Dizzerin/Rocket-Flight-Data-Computer/PCB_Schematics_KiCAD/Schematic.pdf

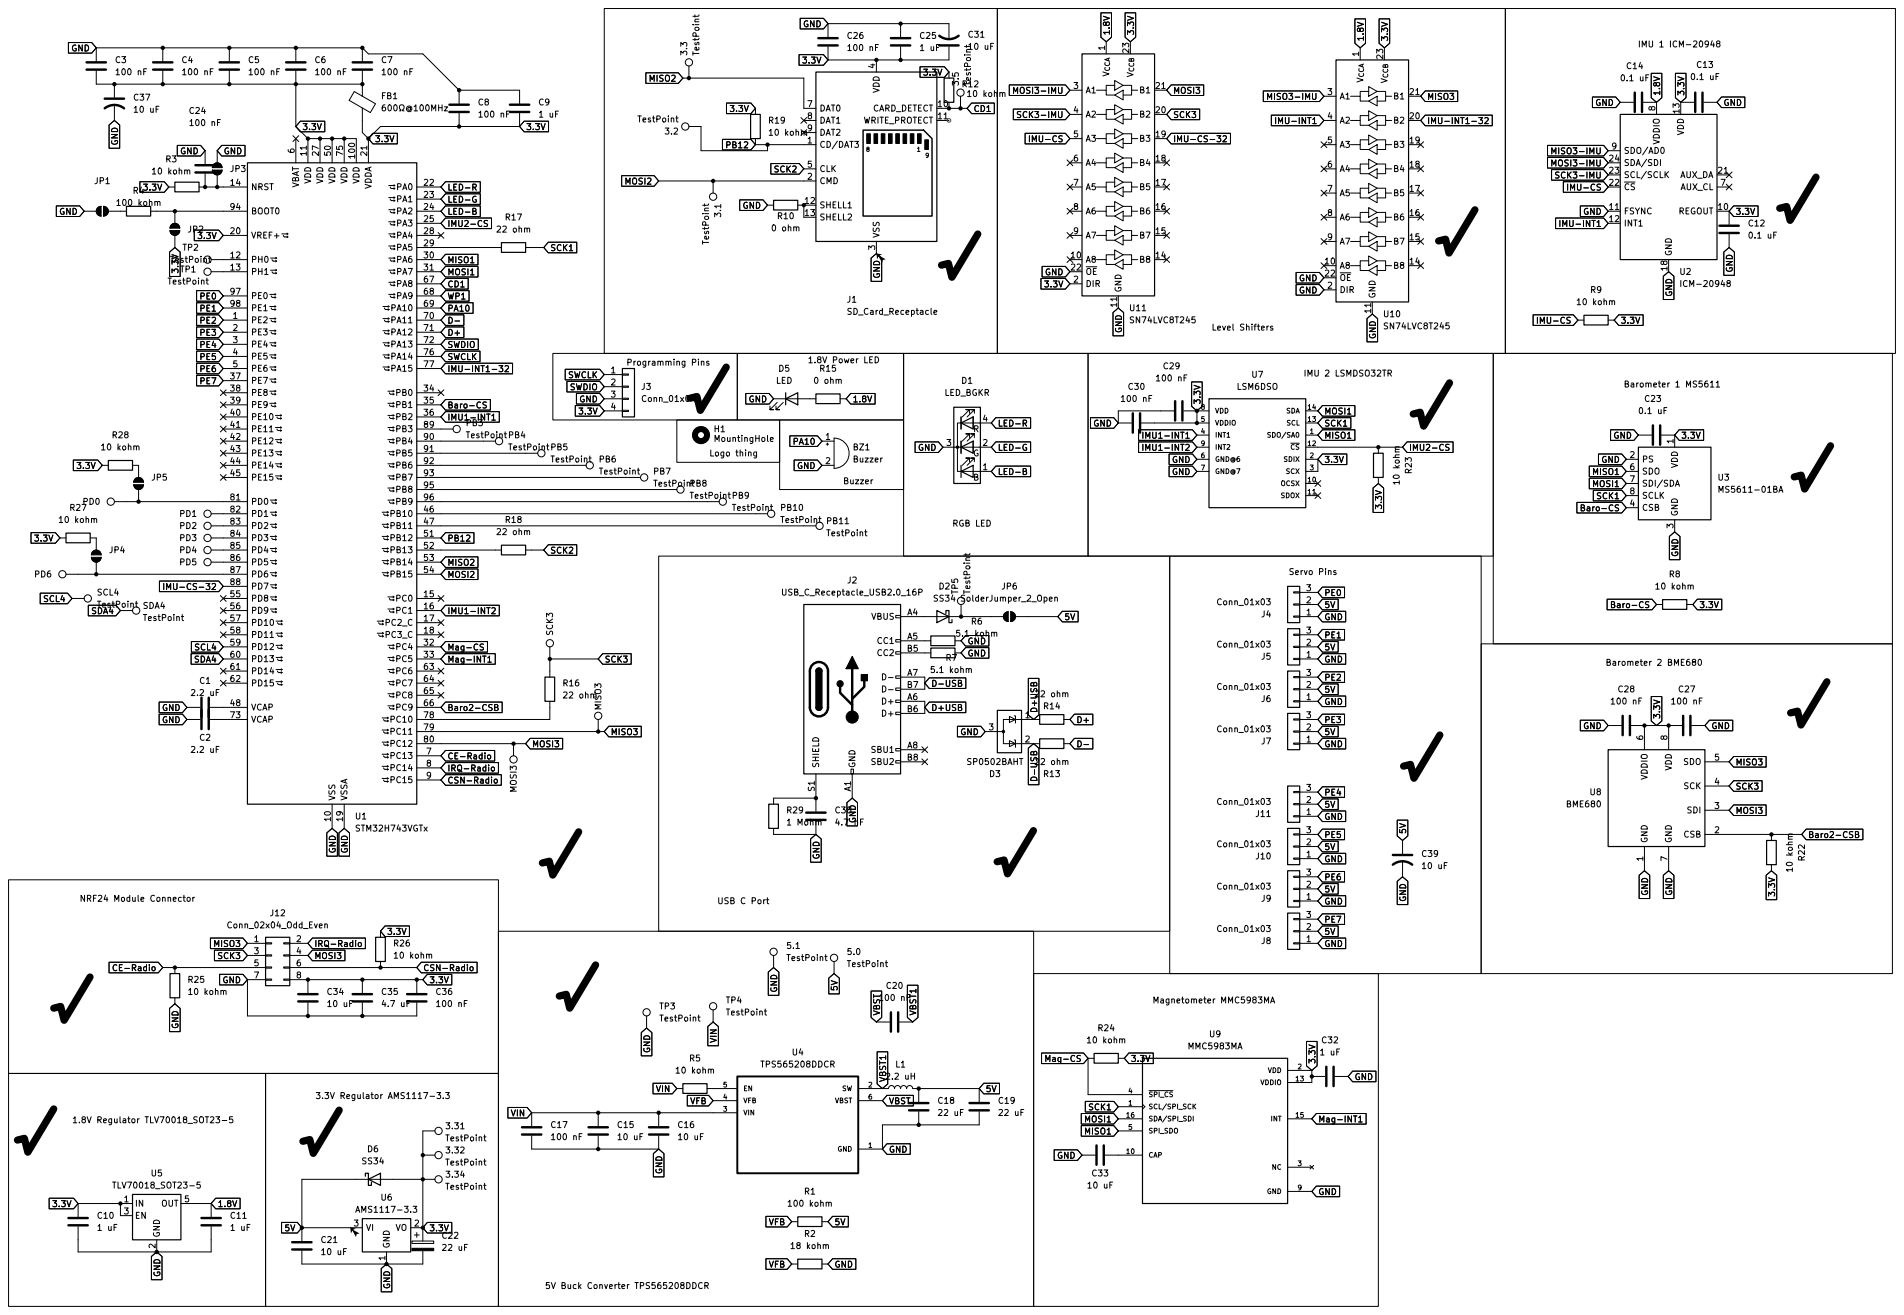
[picture p1: page 1]
