Dizzerin/Rocket-Flight-Data-Computer/PCB_Schematics_KiCAD/GPS module.kicad_sch

## KiCad design PCB_Schematics_KiCAD/GPS module.kicad_sch (2026-04-20)

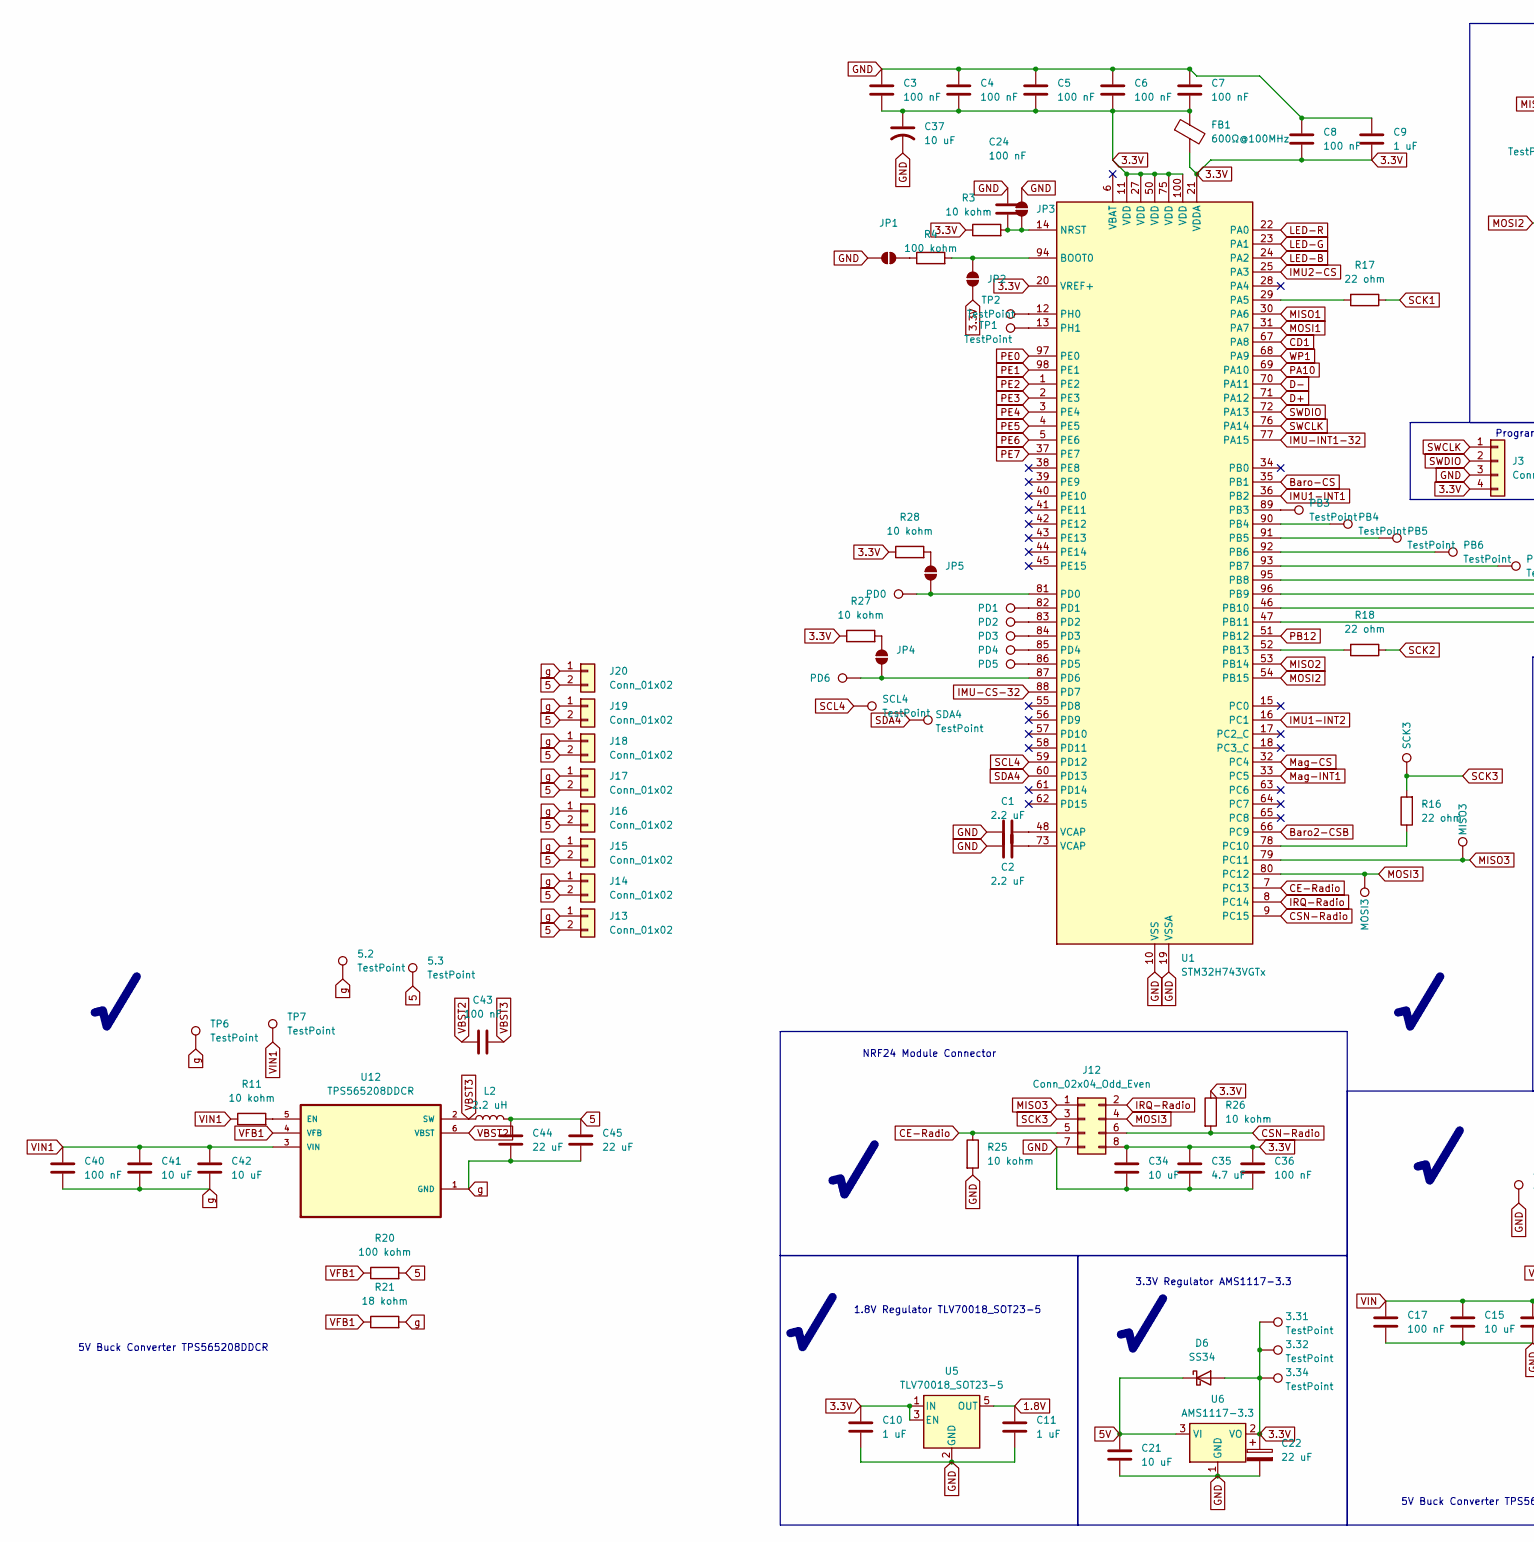
[picture p2: schematic GPS module.kicad_sch, part in row 1, column 1]

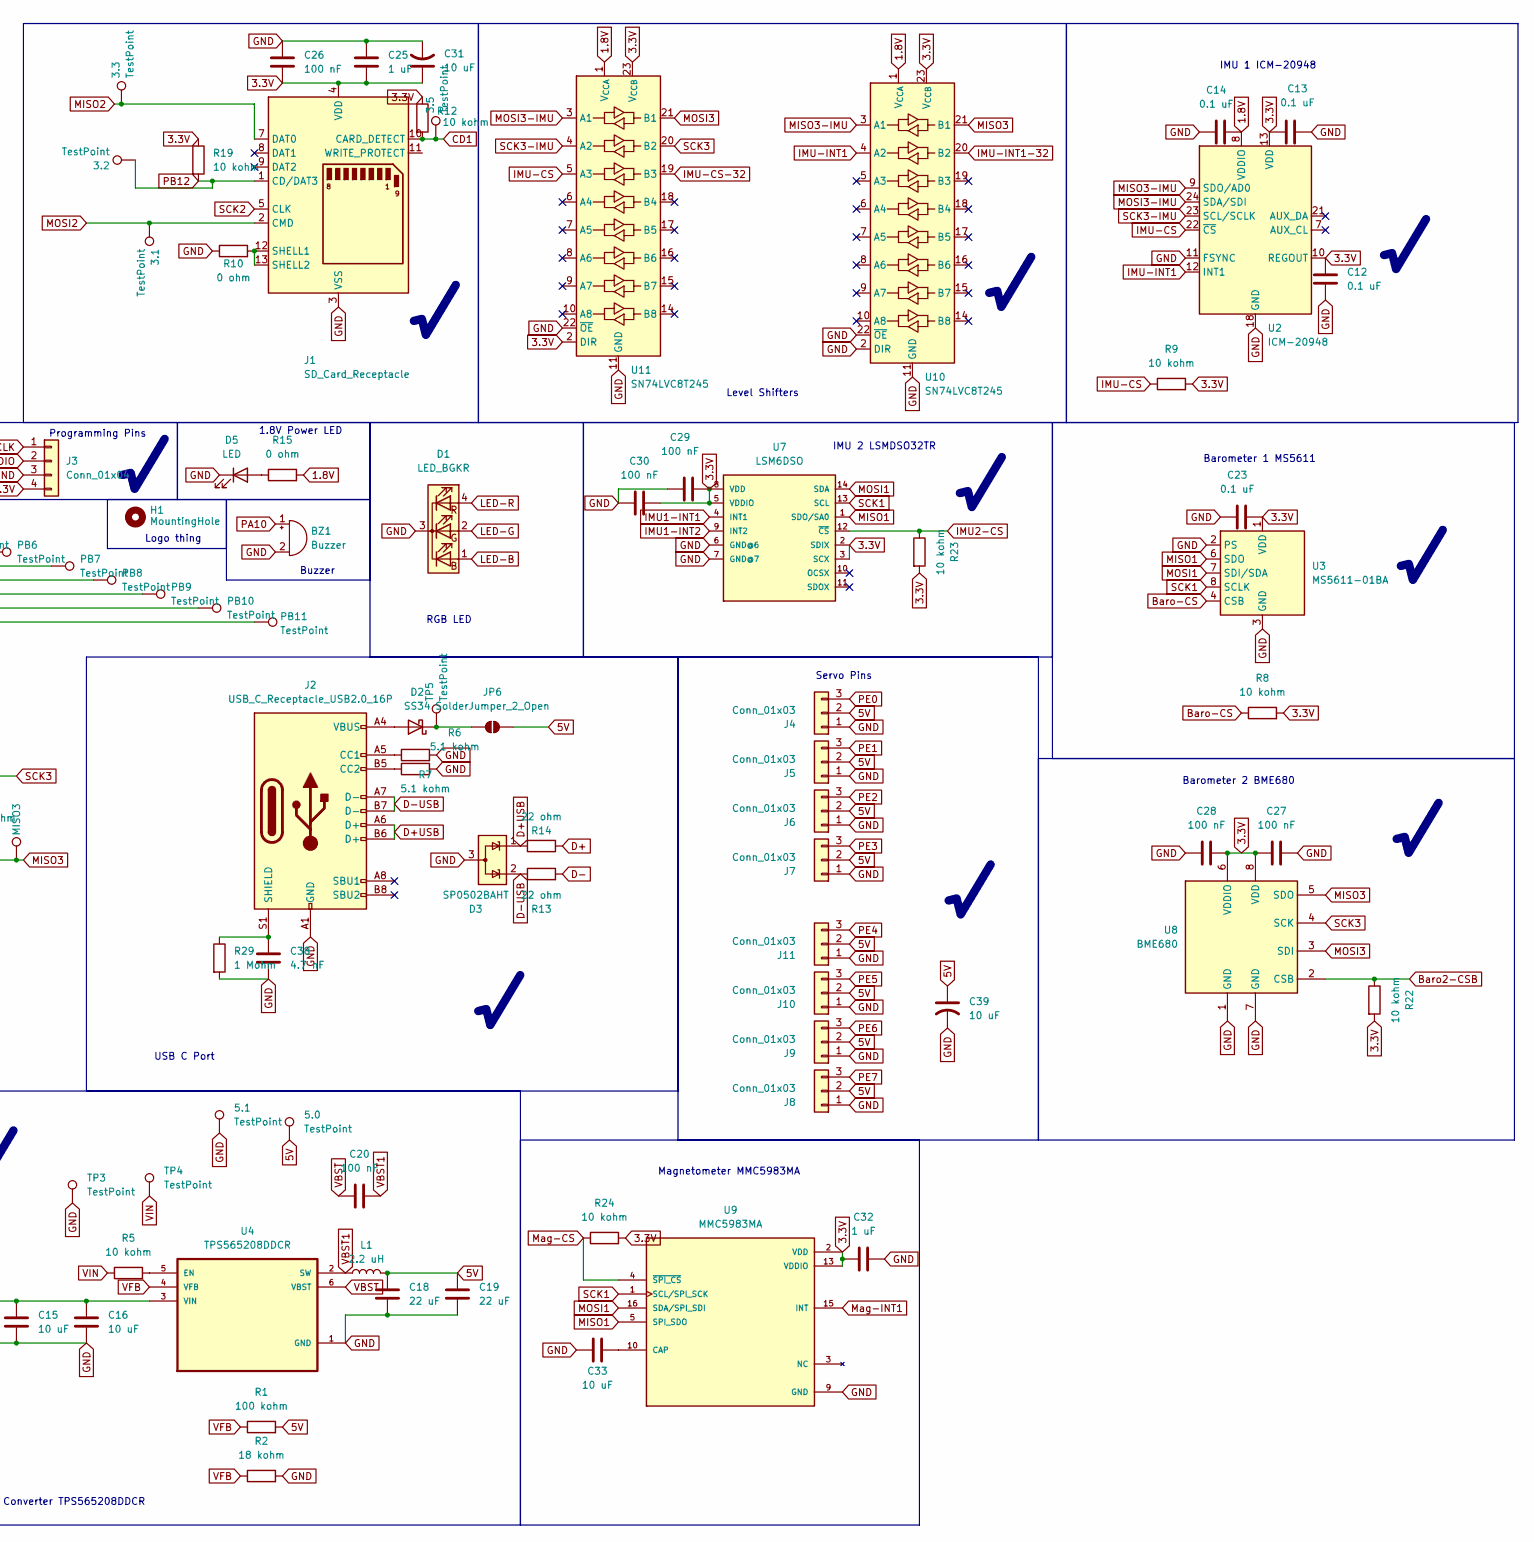
[picture p3: schematic GPS module.kicad_sch, part in row 1, column 2]

Parts:
3.1, 3.2, 3.3, 3.5, 3.31, 3.32, 3.34: TestPoint; TestPoint_THTPad_2.0x2.0mm_Drill1.0mm
5.0, 5.1, 5.2, 5.3: TestPoint; TestPoint_THTPad_D4.0mm_Drill2.0mm
BZ1: Buzzer; Buzzer_12x9.5RM7.6
C1, C2: 2.2 uF; C_0603_1608Metric
C3, C4, C5, C6, C7, C8, C17, C20, C24, C26, C27, C28, C29, C30, C36, C40, C43: 100 nF; C_0603_1608Metric
C9, C10, C11, C25, C32: 1 uF; C_0603_1608Metric
C12, C13, C14, C23: 0.1 uF; C_0603_1608Metric
C15, C16, C21, C33, C34, C41, C42: 10 uF; C_0805_2012Metric
C18, C19, C44, C45: 22 uF; C_1206_3216Metric
C22: 22 uF; CP_Elec_4x5.3
C31, C37, C39: 10 uF; C_Elec_4x5.4
C35: 4.7 uF; C_0805_2012Metric
C38: 4.7 nF; C_0603_1608Metric
D1: LED_BGKR; LED_SK6812_PLCC4_5.0x5.0mm_P3.2mm
D2, D6: SS34; D_SMA
D3: SP0502BAHT; SOT-23
D5: LED; LED_0805_2012Metric
FB1: 600Ω@100MHz; L_0603_1608Metric
H1: MountingHole; idk1
J1: SD_Card_Receptacle; SD_TE_2041021
J2: USB_C_Receptacle_USB2.0_16P; USB_C_Receptacle_GCT_USB4105-xx-A_16P_TopMnt_Horizontal
J3: Conn_01x04; PinHeader_1x04_P2.54mm_Vertical
J4, J5, J6, J7, J8, J9, J10, J11: Conn_01x03; PinHeader_1x03_P2.54mm_Vertical
J12: Conn_02x04_Odd_Even; PinSocket_2x04_P2.54mm_Vertical
J13, J14, J15, J16, J17, J18, J19, J20: Conn_01x02; PinHeader_1x02_P2.54mm_Vertical
JP1, JP2, JP3, JP4, JP5, JP6: SolderJumper_2_Open; SolderJumper-2_P1.3mm_Open_RoundedPad1.0x1.5mm
L1, L2: 2.2 uH; L_Bourns_SRP5030T
MISO3: TestPoint; TestPoint_THTPad_2.0x2.0mm_Drill1.0mm
MOSI3: TestPoint; TestPoint_THTPad_2.0x2.0mm_Drill1.0mm
PB3, PB4, PB5, PB6, PB7, PB8, PB9, PB10, PB11: TestPoint; TestPoint_THTPad_2.0x2.0mm_Drill1.0mm
PD0, PD1, PD2, PD3, PD4, PD5, PD6: TestPoint; TestPoint_THTPad_2.0x2.0mm_Drill1.0mm
R1, R4, R20: 100 kohm; R_0805_2012Metric
R2, R21: 18 kohm; R_0805_2012Metric
R3, R5, R8, R9, R11, R12, R19, R22, R23, R24, R25, R26, R27, R28: 10 kohm; R_0603_1608Metric
R6, R7: 5.1 kohm; R_0603_1608Metric
R10, R15: 0 ohm; R_0603_1608Metric
R13, R14, R16, R17, R18: 22 ohm; R_0603_1608Metric
R29: 1 Mohm; R_0603_1608Metric
SCK3: TestPoint; TestPoint_THTPad_2.0x2.0mm_Drill1.0mm
SCL4: TestPoint; TestPoint_THTPad_2.0x2.0mm_Drill1.0mm
SDA4: TestPoint; TestPoint_THTPad_2.0x2.0mm_Drill1.0mm
TP1, TP2: TestPoint; TestPoint_THTPad_2.0x2.0mm_Drill1.0mm
TP3, TP4, TP6, TP7: TestPoint; TestPoint_Pad_D4.0mm
TP5: TestPoint; TestPoint_Pad_D2.0mm
U1: STM32H743VGTx; LQFP-100_14x14mm_P0.5mm
U2: ICM-20948; InvenSense_QFN-24_3x3mm_P0.4mm
U3: MS5611-01BA; LGA-8_3x5mm_P1.25mm
U4, U12: TPS565208DDCR; SOT95P280X110-6N
U5: TLV70018_SOT23-5; SOT-23-5
U6: AMS1117-3.3; SOT-223-3_TabPin2
U7: LSM6DSO; LGA-14_3x2.5mm_P0.5mm_LayoutBorder3x4y
U8: BME680; Bosch_LGA-8_3x3mm_P0.8mm_ClockwisePinNumbering
U9: MMC5983MA; PQFN50P300X300X100-16N; PARTREV A
U10, U11: SN74LVC8T245; SSOP-24_3.9x8.7mm_P0.635mm

Connections:
1.8V: C11.1, C14.1, R15.2, U2.8 (VDDIO), U5.5 (OUT), U10.1 (V_{CCA}), U11.1 (V_{CCA})
3.3V: 3.31.1, 3.32.1, 3.34.1, C3.2, C4.2, C5.2, C6.2, C7.2, C8.2, C9.2, C10.1, C12.2, C13.2, C22.1, C23.1, C25.2, C26.2, C27.1, C28.2, C29.1, C30.1, C31.1, C32.1, C34.1, C35.1, C36.1, C37.1, D6.2 (A), FB1.1, FB1.2, J1.4 (VDD), J3.4, J12.8, JP2.1 (A), R3.1, R8.2, R9.2, R12.1, R19.1, R22.2, R23.2, R24.2, R26.1, R27.1, R28.1, U1.11 (VDD), U1.20 (VREF+), U1.21 (VDDA), U1.27 (VDD), U1.50 (VDD), U1.75 (VDD), U1.100 (VDD), U2.10 (REGOUT), U2.13 (VDD), U3.1 (VDD), U5.1 (IN), U5.3 (EN), U6.2 (VO), U7.2 (SDIX), U7.3 (SCX), U7.5 (VDDIO), U7.8 (VDD), U8.6 (VDDIO), U8.8 (VDD), U9.2 (VDD), U9.13 (VDDIO), U10.23 (V_{CCB}), U10.24 (V_{CCB}), U11.2 (DIR), U11.23 (V_{CCB}), U11.24 (V_{CCB})
5: 5.3.1, C44.1, C45.1, J13.2, J14.2, J15.2, J16.2, J17.2, J18.2, J19.2, J20.2, L2.2, R20.2
5V: 5.0.1, C18.1, C19.1, C21.1, C39.1, D6.1 (K), J4.2, J5.2, J6.2, J7.2, J8.2, J9.2, J10.2, J11.2, JP6.2 (B), L1.2, R1.2, U6.3 (VI)
Baro2-CSB: R22.1, U1.66 (PC9), U8.2 (CSB)
Baro-CS: R8.1, U1.35 (PB1), U3.4 (CSB), U3.5 (CSB)
CD1: 3.5.1, J1.10 (CARD_DETECT), R12.2, U1.67 (PA8)
CE-Radio: J12.5, R25.1, U1.7 (PC13)
CSN-Radio: J12.6, R26.2, U1.9 (PC15)
D+: R14.1, U1.71 (PA12)
D+USB: D3.1 (K), J2.A6 (D+), J2.B6 (D+), R14.2
D-: R13.2, U1.70 (PA11)
D-USB: D3.2 (K), J2.A7 (D-), J2.B7 (D-), R13.1
GND: 5.1.1, BZ1.2 (-), C1.1, C2.1, C3.1, C4.1, C5.1, C6.1, C7.1, C8.1, C9.1, C10.2, C11.2, C12.1, C13.1, C14.2, C15.2, C16.2, C17.2, C18.2, C19.2, C21.2, C22.2, C23.2, C24.1, C25.1, C26.1, C27.2, C28.1, C29.2, C30.2, C31.2, C32.2, C33.1, C34.2, C35.2, C36.2, C37.2, C38.2, C39.2, D1.3 (K), D3.3 (A), D5.1 (K), J1.3 (VSS), J1.6 (VSS), J2.A1 (GND), J2.A12 (GND), J2.B1 (GND), J2.B12 (GND), J3.3, J4.1, J5.1, J6.1, J7.1, J8.1, J9.1, J10.1, J11.1, J12.7, JP1.1 (A), JP3.2 (B), R2.2, R6.2, R7.2, R10.1, R25.2, R29.2, TP3.1, U1.10 (VSS), U1.19 (VSSA), U1.26 (VSS), U1.49 (VSS), U1.74 (VSS), U1.99 (VSS), U2.11 (FSYNC), U2.18 (GND), U2.20 (GND), U3.2 (PS), U3.3 (GND), U4.1 (GND), U5.2 (GND), U6.1 (GND), U7.6 (GND@6), U7.7 (GND@7), U8.1 (GND), U8.7 (GND), U9.9 (GND), U9.11 (GND), U10.2 (DIR), U10.11 (GND), U10.12 (GND), U10.13 (GND), U10.22 (~OE), U11.11 (GND), U11.12 (GND), U11.13 (GND), U11.22 (~OE)
IMU1-INT1: U1.36 (PB2), U7.4 (INT1)
IMU1-INT2: U1.16 (PC1), U7.9 (INT2)
IMU2-CS: R23.1, U1.25 (PA3), U7.12 (~CS)
IMU-CS: R9.1, U2.22 (~CS), U11.5 (A3)
IMU-CS-32: U1.88 (PD7), U11.19 (B3)
IMU-INT1: U2.12 (INT1), U10.4 (A2)
IMU-INT1-32: U1.77 (PA15), U10.20 (B2)
IRQ-Radio: J12.2, U1.8 (PC14)
LED-B: D1.1 (BA), U1.24 (PA2)
LED-G: D1.2 (GA), U1.23 (PA1)
LED-R: D1.4 (RA), U1.22 (PA0)
MISO1: U1.30 (PA6), U3.6 (SDO), U7.1 (SDO/SA0), U9.5 (SPI_SDO)
MISO2: 3.3.1, J1.7 (DAT0), U1.53 (PB14)
MISO3: J12.1, MISO3.1, U1.79 (PC11), U8.5 (SDO), U10.21 (B1)
MISO3-IMU: U2.9 (SDO/AD0), U10.3 (A1)
MOSI1: U1.31 (PA7), U3.7 (SDI/SDA), U7.14 (SDA), U9.16 (SDA/SPI_SDI)
MOSI2: 3.1.1, J1.2 (CMD), U1.54 (PB15)
MOSI3: J12.4, MOSI3.1, U1.80 (PC12), U8.3 (SDI), U11.21 (B1)
MOSI3-IMU: U2.24 (SDA/SDI), U11.3 (A1)
Mag-CS: R24.1, U1.32 (PC4), U9.4 (~SPI_CS)
Mag-INT1: U1.33 (PC5), U9.15 (INT)
unnamed: C1.2, U1.48 (VCAP)
unnamed: C2.2, U1.73 (VCAP)
unnamed: C24.2, JP3.1 (A), R3.2, U1.14 (NRST)
unnamed: C33.2, U9.10 (CAP)
unnamed: C38.1, J2.S1 (SHIELD), R29.1
unnamed: D2.1 (K), JP6.1 (A), TP5.1
unnamed: D2.2 (A), J2.A4 (VBUS), J2.A9 (VBUS), J2.B4 (VBUS), J2.B9 (VBUS)
unnamed: D5.2 (A), R15.1
unnamed: J1.12 (SHELL1), J1.13 (SHELL2), R10.2
unnamed: J2.A5 (CC1), R6.1
unnamed: J2.B5 (CC2), R7.1
unnamed: JP1.2 (B), R4.1
unnamed: JP2.2 (B), R4.2, U1.94 (BOOT0)
unnamed: JP4.1 (A), PD6.1, U1.87 (PD6)
unnamed: JP4.2 (B), R27.2
unnamed: JP5.1 (A), PD0.1, U1.81 (PD0)
unnamed: JP5.2 (B), R28.2
unnamed: PB3.1, U1.89 (PB3)
unnamed: PB4.1, U1.90 (PB4)
unnamed: PB5.1, U1.91 (PB5)
unnamed: PB6.1, U1.92 (PB6)
unnamed: PB7.1, U1.93 (PB7)
unnamed: PB8.1, U1.95 (PB8)
unnamed: PB9.1, U1.96 (PB9)
unnamed: PB10.1, U1.46 (PB10)
unnamed: PB11.1, U1.47 (PB11)
unnamed: PD1.1, U1.82 (PD1)
unnamed: PD2.1, U1.83 (PD2)
unnamed: PD3.1, U1.84 (PD3)
unnamed: PD4.1, U1.85 (PD4)
unnamed: PD5.1, U1.86 (PD5)
unnamed: R5.2, U4.5 (EN)
unnamed: R11.2, U12.5 (EN)
unnamed: R16.1, U1.78 (PC10)
unnamed: R17.2, U1.29 (PA5)
unnamed: R18.2, U1.52 (PB13)
unnamed: TP1.1, U1.13 (PH1)
unnamed: TP2.1, U1.12 (PH0)
unnamed: U9.3 (NC), U9.6 (NC), U9.7 (NC), U9.8 (NC), U9.12 (NC), U9.14 (NC)
PA10: BZ1.1 (+), U1.69 (PA10)
PB12: 3.2.1, J1.1 (CD/DAT3), R19.2, U1.51 (PB12)
PE0: J4.3, U1.97 (PE0)
PE1: J5.3, U1.98 (PE1)
PE2: J6.3, U1.1 (PE2)
PE3: J7.3, U1.2 (PE3)
PE4: J11.3, U1.3 (PE4)
PE5: J10.3, U1.4 (PE5)
PE6: J9.3, U1.5 (PE6)
PE7: J8.3, U1.37 (PE7)
SCK1: R17.1, U3.8 (SCLK), U7.13 (SCL), U9.1 (SCL/SPI_SCK)
SCK2: J1.5 (CLK), R18.1
SCK3: J12.3, R16.2, SCK3.1, U8.4 (SCK), U11.20 (B2)
SCK3-IMU: U2.23 (SCL/SCLK), U11.4 (A2)
SCL4: SCL4.1, U1.59 (PD12)
SDA4: SDA4.1, U1.60 (PD13)
SWCLK: J3.1, U1.76 (PA14)
SWDIO: J3.2, U1.72 (PA13)
VBST: C20.1, U4.6 (VBST)
VBST1: C20.2, L1.1, U4.2 (SW)
VBST2: C43.1, U12.6 (VBST)
VBST3: C43.2, L2.1, U12.2 (SW)
VFB: R1.1, R2.1, U4.4 (VFB)
VFB1: R20.1, R21.1, U12.4 (VFB)
VIN: C15.1, C16.1, C17.1, R5.1, TP4.1, U4.3 (VIN)
VIN1: C40.1, C41.1, C42.1, R11.1, TP7.1, U12.3 (VIN)
WP1: U1.68 (PA9)
g: 5.2.1, C40.2, C41.2, C42.2, C44.2, C45.2, J13.1, J14.1, J15.1, J16.1, J17.1, J18.1, J19.1, J20.1, R21.2, TP6.1, U12.1 (GND)

Notes on the sheet:
IMU 2 LSMDSO32TR
Barometer 1 MS5611
Magnetometer MMC5983MA
NRF24 Module Connector
1.8V Power LED
Servo Pins
RGB LED
Buzzer
Logo thing
Programming Pins
IMU 1 ICM-20948
Barometer 2 BME680
5V Buck Converter TPS565208DDCR
1.8V Regulator TLV70018_SOT23-5
Level Shifters
3.3V Regulator AMS1117-3.3
USB C Port
