Dizzerin/Rocket-Flight-Data-Computer/STM32_CubeIDE_Rocket_Project/Core/Src/main.c

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
/* Includes ------------------------------------------------------------------*/
#include "main.h"
#include "fatfs.h"

/* USER CODE BEGIN Includes */
#include <stdio.h>
#include <string.h>
#include <stdarg.h> //for va_list var arg functions
#include "lsm6dso32_device.h"
#include "SD_Card.h"
#include "DataLogger.h"
#include "Scheduler.h"
#include <bme680_device.h>
/* USER CODE END Includes */


I2C_HandleTypeDef hi2c4;

SPI_HandleTypeDef hspi1;
SPI_HandleTypeDef hspi2;
SPI_HandleTypeDef hspi3;

UART_HandleTypeDef huart3;

void SystemClock_Config(void);
void PeriphCommonClock_Config(void);
static void MPU_Config(void);
static void MX_GPIO_Init(void);
static void MX_SPI2_Init(void);
static void MX_USART3_UART_Init(void);
static void MX_SPI1_Init(void);
static void MX_I2C4_Init(void);
static void MX_SPI3_Init(void);
/* USER CODE BEGIN PFP */
static void LED_Task(void);
/* USER CODE END PFP */

/* USER CODE BEGIN 0 */
// Function which you can call like any other printf function and the output will come out UART3
void myprintf(const char *fmt, ...) {
  static char buffer[256];
  va_list args;
  va_start(args, fmt);
  vsnprintf(buffer, sizeof(buffer), fmt, args);
  va_end(args);

  int len = strlen(buffer);
  HAL_UART_Transmit(&huart3, (uint8_t*)buffer, len, -1);
}
/* USER CODE END 0 */

/**
  * @brief  The application entry point.
  * @retval int
  */
int main(void)
{

  /* MPU Configuration--------------------------------------------------------*/
  MPU_Config();

  /* MCU Configuration--------------------------------------------------------*/

  /* Reset of all peripherals, Initializes the Flash interface and the Systick. */
  HAL_Init();

  /* Configure the system clock */
  SystemClock_Config();

  /* Configure the peripherals common clocks */
  PeriphCommonClock_Config();

  /* Initialize all configured peripherals */
  MX_GPIO_Init();
  MX_SPI2_Init();
  MX_FATFS_Init();
  MX_USART3_UART_Init();
  MX_SPI1_Init();
  MX_I2C4_Init();
  MX_SPI3_Init();
  /* USER CODE BEGIN 2 */
  HAL_Delay(500);        /* Let peripherals settle after power-on */

  lsm6_init();
  bme680_init();
  SD_Init();
  DataLogger_Init();

  Scheduler_Init();
  Scheduler_RegisterTask(SD_StateMachine,              100);
  Scheduler_RegisterTask(DataLogger_StateMachine_Task,   5);
  Scheduler_RegisterTask(LED_Task,                      50);
  /* USER CODE END 2 */

  /* Infinite loop */
  /* USER CODE BEGIN WHILE */
  while (1)
  {
    /* USER CODE END WHILE */

    /* USER CODE BEGIN 3 */
    Scheduler_Run();
  }
  /* USER CODE END 3 */
}

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
/* USER CODE BEGIN 4 */
/*
 * LED flash pattern task — registered with the scheduler at 50 ms.
 *
 * Flash rates depend on system state:
 *   Logging     : 250 ms on, 250 ms off (2 Hz, symmetric)
 *   Not logging : 500 ms on, 250 ms off (~1.3 Hz, asymmetric)
 *   Error_Handler() fast-blink (100 ms on/off) is handled separately...
 *   ...inside the Error_Handler() itself using a busy-wait loop.
 */
static void LED_Task(void)
{
    static uint8_t  ledIsOn        = 0;
    static uint32_t lastChangeTick = 0;

    uint32_t now = HAL_GetTick();

    /* Pick on/off durations based on whether the DataLogger is actively writing */
    uint32_t onDuration  = DataLogger_IsLogging() ? 250U : 500U;
    uint32_t offDuration = 250U;

    uint32_t phaseDuration = ledIsOn ? onDuration : offDuration;

    if ((now - lastChangeTick) >= phaseDuration) {
        ledIsOn = !ledIsOn;
        HAL_GPIO_WritePin(LED_GPIO_Port, LED_Pin,
                          ledIsOn ? GPIO_PIN_SET : GPIO_PIN_RESET);
        lastChangeTick = now;
    }
}
/* USER CODE END 4 */

 /* MPU Configuration */

void MPU_Config(void)
{
  MPU_Region_InitTypeDef MPU_InitStruct = {0};

  /* Disables the MPU */
  HAL_MPU_Disable();

  /** Initializes and configures the Region and the memory to be protected
  */
  MPU_InitStruct.Enable = MPU_REGION_ENABLE;
  MPU_InitStruct.Number = MPU_REGION_NUMBER0;
  MPU_InitStruct.BaseAddress = 0x0;
  MPU_InitStruct.Size = MPU_REGION_SIZE_4GB;
  MPU_InitStruct.SubRegionDisable = 0x87;
  MPU_InitStruct.TypeExtField = MPU_TEX_LEVEL0;
  MPU_InitStruct.AccessPermission = MPU_REGION_NO_ACCESS;
  MPU_InitStruct.DisableExec = MPU_INSTRUCTION_ACCESS_DISABLE;
  MPU_InitStruct.IsShareable = MPU_ACCESS_SHAREABLE;
  MPU_InitStruct.IsCacheable = MPU_ACCESS_NOT_CACHEABLE;
  MPU_InitStruct.IsBufferable = MPU_ACCESS_NOT_BUFFERABLE;

  HAL_MPU_ConfigRegion(&MPU_InitStruct);
  /* Enables the MPU */
  HAL_MPU_Enable(MPU_PRIVILEGED_DEFAULT);

}

/**
  * @brief  This function is executed in case of error occurrence.
  * @retval None
  */
void Error_Handler(void)
{
  /* USER CODE BEGIN Error_Handler_Debug */
  /* Attempt to print a message before disabling interrupts */
  //myprintf("*** FATAL: Error_Handler called — system halted ***\r\n");

  __disable_irq();

  /* Fast-blink the LED so the fault is visible on the hardware.
     HAL_Delay() requires SysTick, which is interrupt-driven and unavailable
     after __disable_irq(), so we busy-wait instead.
     At 64 MHz HSI, ~1,600,000 loop iterations is approximately 100 ms. */
  while (1)
  {
      HAL_GPIO_TogglePin(LED_GPIO_Port, LED_Pin);
      for (volatile uint32_t i = 0; i < 1600000UL; i++);
  }
  /* USER CODE END Error_Handler_Debug */
}
#ifdef USE_FULL_ASSERT
/**
  * @brief  Reports the name of the source file and the source line number
  *         where the assert_param error has occurred.
  * @param  file: pointer to the source file name
  * @param  line: assert_param error line source number
  * @retval None
  */
void assert_failed(uint8_t *file, uint32_t line)
{
  /* USER CODE BEGIN 6 */
  /* User can add his own implementation to report the file name and line number,
     ex: printf("Wrong parameters value: file %s on line %d\r\n", file, line) */
  /* USER CODE END 6 */
}
#endif /* USE_FULL_ASSERT */
