Dizzerin/Rocket-Flight-Data-Computer/STM32_CubeIDE_Rocket_Project/STM32_CubeIDE_Rocket_Project.ioc

Mcu.UserName=STM32H743VGTx
PA10.GPIO_Label=BUZZER_PIN
PA10.Signal=GPIO_Output
PA3.GPIO_Label=LSM6DSO_CS
PA3.Signal=GPIO_Output
PA5.Signal=SPI1_SCK
PA6.Signal=SPI1_MISO
PA7.Signal=SPI1_MOSI
PA8.GPIO_Label=SD_CARD_DETECT
PA8.Signal=GPXTI8
PB10.Signal=USART3_TX
PB11.Signal=USART3_RX
PB12.GPIO_Label=SD_CS
PB12.Signal=GPIO_Output
PB13.Signal=SPI2_SCK
PB14.Signal=SPI2_MISO
PB15.Signal=SPI2_MOSI
PC10.Signal=SPI3_SCK
PC11.Signal=SPI3_MISO
PC12.Signal=SPI3_MOSI
PC9.GPIO_Label=BARO2_CS
PC9.Signal=GPIO_Output
PD0.GPIO_Label=CAM_CS
PD0.Signal=GPIO_Output
PD12.Signal=I2C4_SCL
PD13.Signal=I2C4_SDA
