Dizzerin/Rocket-Flight-Data-Computer/STM32_CubeIDE_Rocket_Project/Core/Inc/main.h

#define LSM6DSO_CS_Pin GPIO_PIN_3
#define LSM6DSO_CS_GPIO_Port GPIOA
#define SD_CS_Pin GPIO_PIN_12
#define SD_CS_GPIO_Port GPIOB
#define BARO2_CS_Pin GPIO_PIN_9
#define BARO2_CS_GPIO_Port GPIOC
#define SD_CARD_DETECT_Pin GPIO_PIN_8
#define SD_CARD_DETECT_GPIO_Port GPIOA
#define SD_CARD_DETECT_EXTI_IRQn EXTI9_5_IRQn
#define BUZZER_PIN_Pin GPIO_PIN_10
#define BUZZER_PIN_GPIO_Port GPIOA
#define CAM_CS_Pin GPIO_PIN_0
#define CAM_CS_GPIO_Port GPIOD
#define LED_Pin GPIO_PIN_3
#define LED_GPIO_Port GPIOB
#define SD_SPI_HANDLE hspi2
