Dizzerin/Rocket-Flight-Data-Computer/(commit log)

2026-04-20 Added KiCAD PCB Schematic Files
    [GPS module.kicad_sch]
2026-04-20 Added SD Card Card Detect Pin Added CLAUDE.md
2026-04-21 Added pin definitions and assigments for BME680 BARO2 barometer. Also updated the other CS pins to initialize to HIGH output state to ensure default mode is deselected. Regenerated CubeMX code.
2026-04-21 Adding code support for BME680 Barometer measurement sensor
2026-04-21 Corrected indentation in main.c. Updated BME680 code to allow gas measurements to be enabled or disabled, and disabled them by default now.
    [bme680_spi.c, bme680_spi.h, main.c]
2026-04-21 Rebuilt using STM32Cube IDE
2026-04-21 Added interrupt for SD_CARD_DETECT pin.
2026-04-22 Lots of improvements! Created basic task scheduler, created basic data logger module, updated and created state machine for handling SD card better with insert and removal detection, increased poll r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
2026-04-22 Fixed build errors and built it
    [DataLogger.c]
2026-04-22 Added and re-ordered the timestamp values in the log file. Resolved some other TODOs
    [DataLogger.c]
2026-04-22 Changed BME680 SPI clock speed.
2026-04-22 Moved f_sync out of the SD_write function and designed it to be called less often to save SPI bandwidth to the SD card
2026-04-22 Fixed FCLK_FAST() and FCLK_SLOW() macros to work for the STM32H7 processor instead of using the incorrect registers for the STM32F series processors
2026-04-22 Rewrote bme680_spi module to use the BOSCH Sensor Tech provided library/driver code
2026-04-23 Compiled using STM32CubeIDE
2026-04-23 Fixed 4 bugs! 1. SD card removal and remounting bug. 2. DataLogger continuing to trigger BME680 measurements even when SD card is removed and data can't be logged. 3. BME680 get_data failure 4. BME68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
    [DataLogger.c, SD_Card.c, bme680_device.c]
2026-04-23 Added clarifying comments about the behavior and function call chain when SD card is removed and re-insterted.
2026-04-23 Fixed SPI1 bus size, was incorrectly set to 16-bit, updated it to 8-bit in CubeMX and regenerated code. Also fixed issue with include being in a place that CubeMX would overwrite.
    [STM32_CubeIDE_Rocket_Project.ioc, main.c]
2026-04-23 Fixed issue with LSM6SDO SPI platform_read function where it may read stale data. Fixed inverted lsm6_readData success check.
    [DataLogger.c]
2026-04-23 Forgot to stage this file with last commit
2026-04-24 Exchanged FCLK_SLOW and FCLK_FAST macros for fclk_slow and fclk_fast functions that restore the original SPE bit state after they run. Also exchanged call to HAL_SPI_Abort() to HAL_SPI_DeInit() and H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
    [SD_Card.c]
2026-04-24 Changed LSM6DSO Acceleration scale to be 32g's instead of 16g. Also updated and corrected some comments/documentation.
    [DataLogger.c]
2026-04-24 Made the scale of the LSM6DSO sensor now easily configurable via the LSM6DSO_ACCEL_FS and LSM6DSO_GYSO_FS defines in lsm6dso32_device.h. Also set the scale back to 16g for the accelerometer.
2026-04-24 Added note in README about the ability to easily change the scale of the LSM6DSO sensor now.
2026-04-24 Updated the gitignore, and updated the STM32CubeIDE project to generate .bin and .hex files for quick easy flashing to target device for end users. Those files are retained now under the debug and re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
2026-04-24 Added new column to compute and include an estimated AGL altitude in the log file based on the pressure data!
2026-04-24 Fixed typo in comment that lead to build errors
    [DataLogger.c]
2026-04-24 Uncommented call to fclk_slow() call in USER_SPI_deinitialize() to rule out that as the cause of the SD card failing to mount on re-insertion
2026-04-24 Update README.md to clarify known limitations and bugs. Resolved TODO in BME680 state machine.
    [bme680_device.c]
2026-04-24 Implemented different LED flash patterns to indicate system state so you can easily tell if the SD card was succesfully mounted and the system is logging data or not.
2026-04-24 Add UART echo functionality for live CSV logging during testing
    - Introduced DATALOGGER_UART_ECHO to enable/disable live CSV row echoing to UART3.
    - Updated documentation to clarify usage and limitations of the new feature.
2026-04-24 Update SPI bus configuration in README.md for improved clarity and accuracy
2026-04-25 Update README to enhance LED notes and add dynamic pressure effects section
2026-04-25 Add notes on temperature compensation for BME680 pressure readings and accounting for non-standard lapse rates in Flight Data Reference.
2026-04-25 Update zero-g offset explanation to include reference to gyroscope data section
2026-04-25 Add LIPO battery connector suggestion to README
    Added note about including pads for a LIPO battery.
