Dizzerin/Rocket-Flight-Data-Computer/(notices)

Notices in the files:
STM32_CubeIDE_Rocket_Project/Core/Src/main.c:
Copyright (c) 2026 STMicroelectronics.
All rights reserved.
This software is licensed under terms that can be found in the LICENSE file
